SiliconKaiser/mic-assistant/docs/README.md

# Docs

Cross-cutting design docs that don't belong to one component.

- [protocol.md](protocol.md): the device ↔ server wire protocol (WebSocket, audio format, push-to-talk turns, interruption, battery reporting). v1 draft.

Planned:

- `architecture.md`: the power, boot and audio flow from button press to reply
- `decisions.md`: a log of design decisions and why they were made (latch vs deep sleep, 4×AA, Wi-Fi vs Thread)
