SiliconKaiser/mic-assistant/hardware/prototype/README.md

# Prototype hardware

The breadboard build, made from off-the-shelf modules: XIAO ESP32-S3, Adafruit PDM mic, MAX98357A amp, NeoPixel, Pololu latch, and the 5 V regulator.

| File | What it is |
| --- | --- |
| [assembly-guide.md](assembly-guide.md) | Staged build with a check and a test sketch at each step. Start here. |
| [netlist.md](netlist.md) | Every net, the parts list by reference, and the power-up checklist |
| [schematic.svg](schematic.svg) | The same circuit drawn out, for the perfboard build |
| [bom/](bom/) | What was ordered and from where |
