SiliconKaiser/mic-assistant/hardware/datasheets/README.md

# Datasheets

The PDFs are kept locally and ignored by git, since they're the manufacturers' documents. Re-download them from the links below.

| Part | Ref | Local file | Source |
| --- | --- | --- | --- |
| ESP32-S3 (on the XIAO) | U3 | esp32-s3-datasheet.pdf | [Espressif](https://www.espressif.com/sites/default/files/documentation/esp32-s3_datasheet_en.pdf) |
| XIAO ESP32-S3 board schematic | U3 | xiao-esp32s3-schematic.pdf | [Seeed](https://files.seeedstudio.com/wiki/SeeedStudio-XIAO-ESP32S3/res/XIAO_ESP32S3_SCH_v1.2.pdf) · [wiki](https://wiki.seeedstudio.com/xiao_esp32s3_getting_started/) |
| MAX98357A amp chip | U4 | — (blocks automated download) | [Analog Devices](https://www.analog.com/media/en/technical-documentation/data-sheets/MAX98357A-MAX98357B.pdf) |
| Adafruit MAX98357A breakout guide | U4 | adafruit-max98357-guide.pdf | [Adafruit](https://cdn-learn.adafruit.com/downloads/pdf/adafruit-max98357-i2s-class-d-mono-amp.pdf) |
| MP34DT01-M PDM mic chip | U5 | — (blocks automated download) | [ST](https://www.st.com/resource/en/datasheet/mp34dt01-m.pdf) |
| Adafruit PDM mic breakout guide | U5 | adafruit-pdm-mic-guide.pdf | [Adafruit](https://cdn-learn.adafruit.com/downloads/pdf/adafruit-pdm-microphone-breakout.pdf) |
| WS2812B LED | U6 | ws2812b-datasheet.pdf | [Adafruit-hosted](https://cdn-shop.adafruit.com/datasheets/WS2812B.pdf) |
| Adafruit NeoPixel Überguide | U6 | adafruit-neopixel-uberguide.pdf | [Adafruit](https://cdn-learn.adafruit.com/downloads/pdf/adafruit-neopixel-uberguide.pdf) |
| Pololu Mini Pushbutton Power Switch LV | U1 | — (no PDF; specs on page) | [Pololu #2808](https://www.pololu.com/product/2808) |
| Pololu S9V11F5 regulator | U2 | — (no PDF; specs on page) | [Pololu #2836](https://www.pololu.com/product/2836) |
| 1N5817 Schottky | D1 | 1n5817-datasheet.pdf | [Vishay](https://www.vishay.com/docs/88525/1n5817.pdf) |
| 1N4148 signal diode | D2 | 1n4148-datasheet.pdf | [Vishay](https://www.vishay.com/docs/81857/1n4148.pdf) |
| Nichicon UHE 1000 µF | C1 | — (download failed) | [Mouser datasheet](https://www.mouser.com/datasheet/3/497/1/e_uhe.pdf) |
