SiliconKaiser/mic-assistant/hardware/prototype/bom/README.md

# Prototype BOM

| File | What it is |
| --- | --- |
| [bom-mouser.csv](bom-mouser.csv) | Mouser upload BOM (ordered 2026-10-18) |
| [parts-other.csv](parts-other.csv) | Everything else: Pololu, Amazon, local-store items, tools, nice-to-haves |
| [full-parts-list.md](full-parts-list.md), [full-parts-list.csv](full-parts-list.csv) | The original full parts list across all vendors. Out of date: it's based on the XIAO Sense; kept for reference. |
