SiliconKaiser/mic-assistant/hardware/prototype/purchases.md

MOUSER

1
RoHS1
713-113991114
113991114
XIAO ESP32S3 - 2.4GH
Estimated Tariff
OCT 18, 2026
OCT 18, 2026
1
7.490	7.49

1.12

2
RoHS1
485-3492
3492
Adafruit PDM MEMS Mi
OCT 18, 2026
OCT 18, 2026
1
4.950	4.95

3
RoHS1
485-3006
3006
I2S 3W Class D Amp B
OCT 18, 2026
OCT 18, 2026
1
5.950	5.95

4
RoHS1
485-1612
1612
NeoPixel Mini PCB 5
OCT 18, 2026
OCT 18, 2026
1
4.950	4.95

5
RoHS1
647-UHE1A102MPD
UHE1A102MPD
10volts 1000uF 8x20
OCT 18, 2026
OCT 18, 2026
2
0.800	1.60

6	485-3923
3923
Mini Oval Speaker -
OCT 18, 2026
OCT 18, 2026
1
2.440	2.44

7
RoHS1
910-SMD291NL
SMD291NL
Tack Flux No-clean 5
OCT 18, 2026
OCT 18, 2026
1
11.460	11.46

8
RoHS1
485-830
830
4xAA Battery Holder
OCT 18, 2026
OCT 18, 2026
1
2.950	2.95

9
RoHS1
485-4474
4474
USB Type A to Type C
OCT 18, 2026
OCT 18, 2026
1
4.950	4.95

10
RoHS1
485-1609
1609
Perma-Proto Half Bre
OCT 18, 2026
OCT 18, 2026
1
4.500	4.50

11
RoHS1
485-392
392
36-pin Male Header B
OCT 18, 2026
OCT 18, 2026
1
4.950	4.95

12
RoHS2
863-1N5817G
1N5817G
1A 20V
Estimated Tariff
OCT 18, 2026
OCT 18, 2026
2
0.670	1.34

0.00

13	485-3351
3351
Mono Enclosed Speake
OCT 18, 2026
OCT 18, 2026
1
3.950	3.95

POLOLU

1 x #2836 5V Step-Up/Step-Down Voltage Regulator S9V11F5 = 6.95
   2 x #2808 Mini Pushbutton Power Switch with Reverse Voltage
Protection, LV = 9.90

AMAZON

30Pcs Jst Ph 2.0 Connector Kit 2 Pin Jst Connector Micro Wire Connectors Male Female Connectors Plug with 10cm Silicone Wire Cables

USB C Tester Power Meter, 4-30V 0-12A Type-C PD Tester Digital Multimeter, Voltage and Current Tester Meter Voltmeter, Power Bank Capacity USB Cable Charger Detector (KWS-2303C)
