SiliconKaiser/mic-assistant/hardware/pcb/bom/bom-lcsc.csv

LCSC Part Number | Quantity | Manufacturer Part Number | Manufacturer | Description | Customer Part Number
C49247023 | 1 | 4230BOX-4Ω3W-2P1.25 | XHXDZ | Enclosed speaker 42x30x9.1 mm, 1.25 mm 2-pin plug | LS1
C49247004 | 1 | 3525BOX-4Ω3W-2P1.25 | XHXDZ | Enclosed speaker 35x25x6.3 mm, 1.25 mm 2-pin plug | LS1 (alt)
C157955 | 1 | PHR-2 | JST | JST PH 2-pin housing for the battery lead (mates with J1) | P1
C111515 | 2 | SPH-002T-P0.5S | JST | JST PH crimp contact, 24-30 AWG | P1 contacts
