SiliconKaiser/mic-assistant/hardware/prototype/bom/full-parts-list.csv

Have | Category | Item | Qty | Required | Likely have | Approx. USD | Spec and role | Link
yes | Tools | Computer with ESP-IDF (or Arduino/PlatformIO) | 1 | Required | Yes | 0 | Flashing firmware. ESP-IDF gives the boot-time controls needed for the 300 ms target.
 | Passives & small parts | Signal diode, 1N4148 | 1 | Required | Yes | 0.05 | Lets a GPIO read the PTT button without battery voltage reaching it. Chosen for its nanoamp leakage while the device is off.
 | Passives & small parts | Ceramic capacitor, 0.1 µF | 3 | Required | Yes | 0.1 | XIAO 5V pin, battery divider, spare.
 | Passives & small parts | Resistors, 200 kΩ and 100 kΩ | 1 each | Required | Yes | 0.1 | Battery divider to the ADC: 6.4 V from fresh cells reads as about 2.1 V. It sits after the latch, so it draws nothing when off.
 | Passives & small parts | Resistor, 100 kΩ | 1 | Optional | Yes | 0.1 | Pull-down on the latch's OFF pin so it can't trigger during boot. Optional safety.
 | Passives & small parts | Resistor, 10 kΩ | 1 | Required | Yes | 0.1 | Pull-down on the amp's SD pin. Keeps the amp off, with no pop, until the firmware turns it on.
 | Passives & small parts | Schottky diode, 1N5817 (or SS14) | 1 | Required | Maybe | 0.2 | Between the regulator and the XIAO's 5V pin, as the Seeed wiki requires. Also stops USB from back-feeding the regulator.
 | Passives & small parts | Electrolytic capacitor, 100 µF | 1 | Required | Yes | 0.3 | At the amp's VIN.
 | Passives & small parts | Ceramic capacitor, 10 µF | 2 | Required | Yes | 0.3 | One at the amp's VIN, one at the XIAO's 5V pin.
 | Passives & small parts | Electrolytic capacitor, 1000 µF, 10 V or higher, low-ESR | 1 | Required | Maybe | 1 | Bulk cap on the 5 V rail, close to the regulator. Absorbs Wi-Fi and speaker current spikes that cause brownouts.
 | Prototyping & wiring | Male header pins, 0.1 in | 2 strips | Required | Yes | 1 | The XIAO and the Pololu boards need headers soldered on. Pololu includes them; check the XIAO package.
 | Passives & small parts | Momentary pushbutton, low bounce | 1 | Required | Maybe | 2 | The PTT button: 12 mm tactile or a panel-mount one. Pololu warns that buttons bouncing for several ms may not trigger the latch reliably.
 | Passives & small parts | Status LED: one WS2812/SK6812 (NeoPixel) breakout, or a common-cathode RGB LED + 3× 330 Ω | 1 | Required | Maybe | 2 | Listening, thinking and error states. For a first test, the XIAO's built-in LED (GPIO21) is enough.
 | Project-specific | 4×AA battery holder with leads | 1 | Required | Maybe | 3 | Four cells instead of three: less current per cell and less sag at Wi-Fi peaks. Skip models with a built-in switch, or leave the switch on.
 | Prototyping & wiring | Double-sided foam tape, zip ties | some | Required | Yes | 3 | Holding the speaker, battery pack and boards in place.
 | Prototyping & wiring | JST-PH 2-pin pigtails | 2 pairs | Optional | Maybe | 3 | Plug-in battery and speaker leads instead of hard-wiring.
 | Project-specific | Speaker, 8 Ω 1 W: Adafruit enclosed #5986 (or mini oval #3923) | 1 | Required | No | 4 | 8 Ω draws about half the peak current of 4 Ω. The enclosed one sounds better without a case. Cut off the connector and use the amp's screw terminal.
 | Prototyping & wiring | Perfboard or solderable protoboard | 1 | Later | Maybe | 4 | Second build, once the breadboard version works.
 | Project-specific | Pololu Mini Pushbutton Power Switch LV (#2808) | 1 | Required | No | 4.95 | The power latch. 2.2–16 V, about 0.01 µA when off. A high pulse on OFF cuts power. | https://www.pololu.com/product/2808
 | Optional upgrades & spares | Spare Pololu #2808 latch | 1 | Optional | No | 4.95 | It's cheap, and a wiring mistake can kill one. | https://www.pololu.com/product/2808
 | Project-specific | AA alkaline cells | 4 + 4 spare | Required | Yes | 5 | Spares for testing with partly drained cells.
 | Prototyping & wiring | Full-size breadboard | 1 | Required | Yes | 5 | First build. Fine for signals, but its contacts sag under high current, so move the power path to wire or perfboard if you see brownouts.
 | Prototyping & wiring | Jumper wires, short (male-male) | 1 kit | Required | Yes | 5 | Keep I2S and mic wires short; long jumpers add noise.
 | Prototyping & wiring | Hookup wire, 22–24 AWG (silicone or stranded) | 1 roll | Required | Yes | 5 | Battery, latch, regulator and amp power path.
 | Prototyping & wiring | Heat-shrink tubing | assortment | Required | Yes | 5 | Insulating battery and speaker leads.
 | Prototyping & wiring | USB-C data cable | 1 | Required | Yes | 5 | Flashing and serial logs. Must carry data, not just charge.
 | Optional upgrades & spares | External I2S mic: Adafruit SPH0645 breakout, or a generic INMP441 module | 1 | Optional | No | 5 | If the built-in mic is too weak from across a room. Adafruit discontinued the ICS-43434 and names the SPH0645 as its replacement; the SPH0645 needs a known I2S timing workaround on the ESP32-S3. | https://adafruit.com/product/6049
 | Optional upgrades & spares | TI TPL5110 nano-power timer breakout | 1 | Optional | No | 5 | Scheduled wakes (battery report, update check) while staying fully off in between, at about 35 nA.
 | Project-specific | Adafruit MAX98357A I2S amp breakout (#3006) | 1 | Required | No | 6 | Speaker amp. Runs on 2.5–5.5 V, so it goes on the 5 V rail. Screw terminal for the speaker; SD pin shuts it off.
 | Optional upgrades & spares | Small project box, or a 3D-printed case | 1 | Optional | Maybe | 7.5 | Speakers sound much better with a sealed back volume. The mic needs a port hole; the LED needs a light pipe or diffuser.
 | Optional upgrades & spares | Plain XIAO ESP32-S3 (non-Sense) | 1 | Optional | No | 8 | If you move to an external mic: smaller, and frees the camera connector's pins.
yes | Tools | Wire strippers, flush cutters | 1 each | Required | Yes | 10 | Stripping and trimming wire and leads.
yes | Tools | Helping hands or a PCB holder | 1 | Optional | Yes | 10 | Easier soldering of small boards.
yes | Optional upgrades & spares | Lithium AA cells (Energizer L91) | 4 | Optional | No | 10 | Diagnosing sag: if a brownout disappears on lithium cells, alkaline internal resistance is the cause.
no | Project-specific | Pololu S9V11F5 5 V buck-boost regulator (#2836) | 1 | Required | No | 12 | Stable 5 V from the falling battery voltage. 2–16 V in (needs 3 V to start), about 1.5 A out. No reverse-polarity protection; the latch in front provides it. | https://www.pololu.com/product/2836/specs
no | Tools | Logic analyzer, 8-channel | 1 | Optional | Maybe | 12.5 | Times press, then power good, then firmware running, then first audio frame.
no | Project-specific | Seeed XIAO ESP32-S3 Sense | 1 | Required | No | 14 | Brain and mic. 8 MB PSRAM, 8 MB flash, built-in PDM mic (GPIO41/42), 2.4 GHz Wi-Fi. Ships with an external antenna. | https://wiki.seeedstudio.com/xiao_esp32s3_getting_started/
no | Tools | USB power meter | 1 | Optional | Maybe | 15 | Quick current readings while powered over USB.
yes | Tools | Multimeter with a µA range | 1 | Required | Yes | 25 | Check that off current is near 0 and check rail voltages.
yes | Tools | Soldering iron, solder, flux | 1 | Required | Yes | 30 | Headers, diodes and perfboard.
no | Tools | Bench power supply with current limit | 1 | Optional | Maybe | 50 | Feed in 4.0 V or 3.2 V to imitate drained cells and find where it browns out.
no | Tools | Nordic PPK2 power profiler | 1 | Optional, very useful | No | 100 | Shows current spikes, voltage sag and press-to-awake time in one trace.
