SiliconKaiser/mic-assistant/firmware/main/secrets.example.h

// Copy to secrets.h (ignored by git) and fill in. See docs/protocol.md "Wi-Fi and credentials".
#pragma once

namespace secrets {

// Must be a 2.4 GHz network: the ESP32-S3 has no 5 GHz radio. (A dual-band network with one
// name is fine; the device joins its 2.4 GHz side.)
inline constexpr const char *WIFI_SSID = "your-network";
inline constexpr const char *WIFI_PASSWORD = "your-password";

// The home server running server/mic_server.py: the Linux box, at its reserved IP. An IP, not an
// mDNS name: <host>.local only resolved to IPv6 on this LAN (2026-10-24).
inline constexpr const char *SERVER_HOST = "192.168.4.102";
inline constexpr int SERVER_PORT = 8765;

// Must match MIC_DEVICE_TOKEN in the server's env file (local/server.env).
inline constexpr const char *DEVICE_TOKEN = "change-me";

// Static IP: skips DHCP, which cost 1-1.5 s per cold boot (2026-10-24). Use the address of a
// DHCP reservation for this device on the router (or a free one outside the DHCP pool).
// Leave DEVICE_IP empty to use DHCP.
inline constexpr const char *DEVICE_IP = "";
inline constexpr const char *GATEWAY = "";
inline constexpr const char *NETMASK = "";
inline constexpr const char *DNS_SERVER = "";

}  // namespace secrets
