SiliconKaiser/mic-assistant/(commit log)

2026-10-18 Add prototype parts lists, BOMs, and photos of owned parts
    [bom-lcsc.csv, bom-mouser.csv, parts-list.csv, parts-other.csv]
2026-10-18 Add JST-PH kit and USB-C power meter (Amazon) to parts-other
    [parts-other.csv]
2026-10-19 Clarify JST-PH sourcing note
    [parts-other.csv]
2026-10-19 Move remaining LCSC parts to the Mouser BOM
    [bom-lcsc.csv, bom-mouser.csv]
2026-10-19 Add prototype schematic (schemdraw) and netlist
2026-10-19 Add staged prototype assembly guide with bench test sketches
2026-10-19 Reorganize repo: docs, hardware/prototype, hardware/pcb, firmware, server, enclosure; untrack photos into notes/
    [bom-mouser.csv, parts-list.csv, parts-other.csv]
2026-10-19 Remove generated schematic; rename original parts list to full-parts-list
    [full-parts-list.csv]
2026-10-19 Set up ESP-IDF firmware project with per-board configs
2026-10-24 Convert firmware to C++; retry power-off and protect the amp pins
    - main/power/battery are now .cpp; pins are constexpr in namespace board
    - power::off() confirms VSW dropped after each OFF pulse and retries
    - power::init() leaves the amp pins floating; power::vsw_present() gates audio
    - No exceptions/RTTI; document the C++ subset and bench findings in comments
2026-10-24 Record prototype bench-test results; add purchases list
    All assembly-guide stages pass. Guide and netlist now reflect 4xAA cells
    (up to 6.8 V), arduino-cli setup, the meter uA-range pitfall, and that the
    amp needs the latch on even over USB.
2026-10-24 Add NeoPixel driver; light it first thing as a boot indicator
    RMT bytes encoder, no managed component. Measured press-to-LED on the
    prototype: ~58 ms (7 frames at 120 fps), vs ~130 ms for the Arduino sketch.
2026-10-24 Add PDM mic capture and a push-to-talk flow
    - mic.cpp: PDM RX on I2S0, 10 ms DMA frames, 30 s PSRAM buffer, and a
    DC-blocking high-pass (the raw output drifts by thousands for seconds
    after power-up; the S3 has no hardware PDM high-pass)
    - main.cpp: listen right after boot, record while S1 is held, log levels
    at the end; on USB, wait for the next S1 press instead of stopping
    - Measured on the prototype: ~75 ms from press to first audio; silence
    RMS ~6, speech RMS ~60
    [main.cpp, mic.cpp, mic.h]
2026-10-24 Add speaker playback; play each recording back as an audio check
    - amp.cpp: MAX98357A on I2S1, both slots, 20 ms fades, zeros around the
    audio so SD switches in silence, peak limit for the 1 W speaker, and
    only when VSW is present; pins float again afterward
    - main.cpp: after recording, play it back at 16x gain (LED purple)
2026-10-24 Send each recording to the computer as a .wav over USB
    - dump.cpp: base64 block with a zlib-compatible CRC-32, only when a USB
    host is connected (debug only)
    - tools/monitor.py: serial monitor that survives resets and saves the
    blocks to local/recordings/
    [dump.cpp, dump.h, main.cpp, monitor.py]
2026-10-24 Make the 4 ohm enclosed speaker the prototype's main speaker
    Much fuller sound than the bare 8 ohm 1 W mini oval, and 16x speech
    playback ran on battery without resets. Notes now say the volume cap
    mainly bounds supply current, and that dumped .wav files are pre-gain.
    [amp.cpp, amp.h, monitor.py]
2026-10-24 Draft the device-server protocol (v1)
    WebSocket on the LAN, PCM audio in binary frames, JSON control
    messages, explicit push-to-talk turns and interruption, with the
    mapping to OpenAI Realtime and Gemini Live.
2026-10-24 Stream turns to the home server over Wi-Fi; add the echo server
    - firmware: wifi.cpp joins the network from secrets.h (not in git; build
    fails with a pointer to secrets.example.h until filled in); session.cpp
    speaks docs/protocol.md over esp_websocket_client; an uplink task
    streams the PSRAM backlog then live audio at 16x gain; the reply is
    buffered in PSRAM and played at the server's sample rate
    - amp::play takes a sample rate; its buffers are static, and app_main's
    stack is 8 KB (the 3.5 KB default overflowed); 1.5 MB app partition
    - server/mic_server.py: protocol server with an echo backend, saving
    each turn as a .wav; config from local/server.env
    - Measured: release to first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
    [amp.cpp, amp.h, credentials.h, main.cpp, secrets.example.h, session.cpp]
2026-10-24 Cut cold-boot network time: static IP, cached AP, ARP warm-up
    Per-stage timing in the run summary showed where cold boots spent time:
    - static IP (secrets.h, backed by a DHCP reservation): DHCP took 1-1.5 s
    - cache the AP's channel and BSSID in NVS: a full scan took ~0.7 s,
    the cached join ~200 ms (falls back to a scan if the AP is gone)
    - re-ask ARP every 50 ms before connecting: the Mac often misses the
    first request and lwIP only retries once a second
    - initial TCP RTO 1.5 s -> 300 ms: stalls right after connecting
    - deauthenticate before power-off
    Joined ~200 ms, WebSocket up 80-260 ms later in most boots. About 1 in
    5 boots still waits ~2.3 s for the driver to find the cached AP.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
    [main.cpp, secrets.example.h, session.cpp, session.h, wifi.cpp, wifi.h]
2026-10-24 Add a join watchdog for the occasional slow Wi-Fi join
    Some cold boots the driver didn't see the cached AP on its first look
    and only retried ~2.3 s later. If we haven't joined 400 ms after start,
    restart the attempt (keeping the cached AP). Forced at 100 ms, joins
    still completed in 222-276 ms, so a restart costs ~120 ms.
    [main.cpp, wifi.cpp, wifi.h]
2026-10-24 Bridge to Gemini Live; stream the reply as it arrives
    - server: pluggable backends (gemini, echo). Gemini Live with automatic
    activity detection off (button press/release = activityStart/End),
    connected in parallel with the user talking, session resumption for
    follow-ups within MIC_CONVERSATION_SECONDS, transcripts in the log,
    --list-live-models; default model gemini-3.8-live
    - device: play the reply while it streams in (after ~150 ms of buffer),
    with a stall guard; keep recording 250 ms after release (people let
    go while finishing the last word, which Gemini's transcript lost)
    - amp: begin/write/end streaming API; play() built on it
    Release to first sound: ~1.0-1.15 s (Gemini ~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
    [amp.cpp, amp.h, main.cpp, session.cpp, session.h]
2026-10-24 Make replies interruptible with a new press
    - device: a press (debounced 30 ms) while waiting for or playing a reply
    starts the mic at once, fades playback out, reports how much was
    heard (played_ms minus the amp's queue) and streams a new turn on the
    same connection; replies tagged with an older turn_id are dropped
    - server: replies carry the turn they answer; the new turn's
    activityStart makes Gemini cancel the old reply, and anything the old
    reply still sends before the new activityEnd is discarded
    Tested against Gemini with a fake device (interrupt 0.5 s into a reply,
    new question answered as turn 2) and on the prototype.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
2026-10-24 Run the server on dell-box; replace stale device connections
    - server/mic-assistant.service: systemd user unit for the Linux server;
    README documents setup (uv venv, no sudo) and deploying changes
    - a new connection from a device replaces its earlier one: if the device
    reset or lost power mid-turn, the old connection lingered ~50 s and its
    Gemini session blocked resuming ("session is already connected to an
    existing client"), so the next press got no answer
    - if resuming still fails, start a new conversation instead of failing
    - firmware template points at dell-box's reserved IP (mDNS only gave IPv6)
    [secrets.example.h]
2026-10-24 Enable Google Search grounding for Gemini
    Without it the model declined questions about current events, weather
    or prices; with it (checked on gemini-3.8-live) it answers from search.
2026-10-24 Add a parametric OpenSCAD case, v1 concept
    Tabletop box, ~88 x 84 x 63 mm: battery holder on the base, protoboard on
    rails above it, speaker up under a grille at the back, a large printed
    button at the front over the tactile switch, with the LED lighting the
    button. Shell prints upside down without supports; base screws on from
    below. Part dimensions not yet measured are marked MEASURE.
    [case.scad]
2026-10-31 Drop the unneeded prototype capacitors; add a schematic
    - netlist: C1, C2, C3 and C6 removed (2026-10-24); the build ran fine
    without them, not yet tested on drained cells. Remaining refs keep
    their numbers
    - schematic.svg: the same circuit drawn out, for the perfboard build
2026-10-31 Draft the PCB netlist and BOMs
    - netlist.md: every net pin by pin, ready to enter in KiCad. ESP32-S3-
    WROOM-1-N8R8, MCU-held FET latch (AO3401A + 2N7002, PWR_HOLD on GPIO4)
    with reverse-polarity protection, TPS63070 buck-boost, AP2112K 3.3 V
    LDO, MAX98357A, MP34DT05 mic; prototype GPIOs kept
    - bom/: full BOM, JLCPCB assembly BOM and LCSC BOM for off-board parts,
    part numbers and stock checked 2026-10-24
    [bom-full.csv, bom-jlcpcb.csv, bom-lcsc.csv]
2026-10-31 Start over when S1 is pressed during power-off
    A press while the latch was powering down turned it back on, but
    power::off() took that as a missed OFF pulse: it pulsed again (ignored
    while S1 held latch pin A low), gave up after 3 tries, and app_main then
    waited for a USB-style press with the LED off and the latch on, draining
    the cells. A press before power-off was also waited out and lost.
    off() now returns true when S1 is held 30 ms before a pulse or while
    power fades after one, and app_main starts a new run at once, as after
    power-on. Built; not yet tested on the prototype.
    [main.cpp, power.cpp, power.h]
2026-10-31 Set the reply volume by voice
    - server: a set_volume tool (absolute level or relative change, 10-100%)
    and per-device volume kept in local/device-settings.json, default 40%.
    Reply audio is scaled on the server in equal dB steps, from 1/40 at
    10% to full scale at 100%. The level is stored before the tool result
    goes back, so the spoken confirmation already plays at the new volume
    - server: a turn_complete that ends a tool-call turn no longer closes the
    reply. Gemini speaks in the next turn, after the tool's result; before,
    the device got an empty reply and powered off (also hit run_command)
    - firmware: VOLUME 0.8 is now the ceiling, the server's 100%
    Tested against gemini-3.8-liv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
    [main.cpp]
2026-10-31 Clean the device's audio before Gemini hears it
    UplinkCleaner, streaming in fixed 10 ms blocks (same result whatever the
    frame size; 2 ms lookahead; ~0.6% of real time):
    - pops: single-sample spikes (an electrical fault on the prototype since
    ~00:00 on 10-31, 3-58/s) are interpolated away; 13.1 -> 0.5/s median
    on the 10-31 recordings
    - release click: a jump to near full scale out of quiet is ducked
    -30 dB until it dies down; click peaks 32768 -> ~2700 median. Loud
    speech doesn't trigger it (it's already loud before its peaks)
    - 4th-order high-pass at 180 Hz: the click rings at ~150 Hz (a case
    resonance), plus rumble
    Raw audio is still saved as before; the cleaned turn is saved nex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
2026-10-31 Add a child mode for a five-year-old listener
    MIC_AUDIENCE=child swaps the system prompt for one written for a young
    child and refuses MIC_SHELL=on. The Live API rejects safety_settings, so
    the prompt and Gemini's default filters carry it.
